Ahmad-Zaki05/The-Pythons-Open-Weight-Soccer/(commit log)

2023-08-22 Uploaded a motion testing code for our first prototype robot
2023-08-25 Added IR sensors to the code
    Added IR sensors to detect white lines to the code
2023-09-02 Added IMU, Camera serial communication and IR sensors
    -Added IMU usage for maintaining a constant heading
    -Added angles algorithm for robot's ball tracking (we get the angle value from the camera and make the robot move towards this angle)
    -Added IR sensors readings to detect lines on field
2023-09-02 Create The_Pythons_Arduino_Nano_Code.ino
    - Added IMU MPU9250 usage with Arduino Nano
    - Added UART communication with Arduino Mega to send yaw angle
2023-12-24 Changed handling of data from camera, Added usage of IMU data
    -Changed how data from camera is processed.
    -Added usage of IMU yaw angle to maintain heading of robot while moving and stationary.
2023-12-24 Discarded use of DMP in MPU9250 and used raw values to calculate robot heading, Added offset values after calibration using motioncal
    -A complementary filter is being used now to adjust yaw angle values between magnetometer readings and gyroscope readings which lowered initialization time drastically.
2024-02-09 Added IR Lines Sensors Functionality & Calibration Algorithm
    -Added IR calibration algorithm to get min and max values of each sensor and define each sensor range of reading and saving it to EEPROM
2024-02-09 Adjusted offset of magnetometer and gyroscope reading
    - Recalibrated magnetometer and gyroscope
    - Changed the sending of data to be integers not characters
2024-02-09 Added Camera Codes (Striker & Defender)
2024-02-21 Added motion limit for only goal width, Added switch for goals
    -Motion is now horizontally limited to the goal width
    -Added switch to determine which goal to defend.
2024-02-21 Added switch for goal, Changed last ball angle to last ball x coordinate
    -Added switch to determine which goal to shoot at.
    - Changed last ball angle to last ball x coordinate
2024-02-21 Separated arduino mega code for striker and keeper, Added switch for turning off motion , Added IR Sensors
    - Separated arduino mega code into two codes, one for striker and one for keeper.
    - Added switch for turning off motion for easier debugging
    - Added usage of IR Sensors
    - Added Calibration for IR sensor readings
